davidstrasak/Bachelors_Text/images/MobilniSetup.png

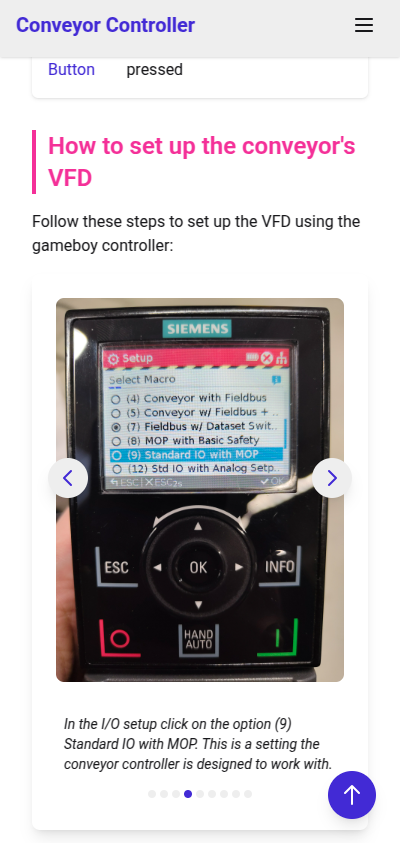
images/MobilniSetup.png
