davidstrasak/Bachelors_Text/images/zadni_LCD_s_I2C.jpg

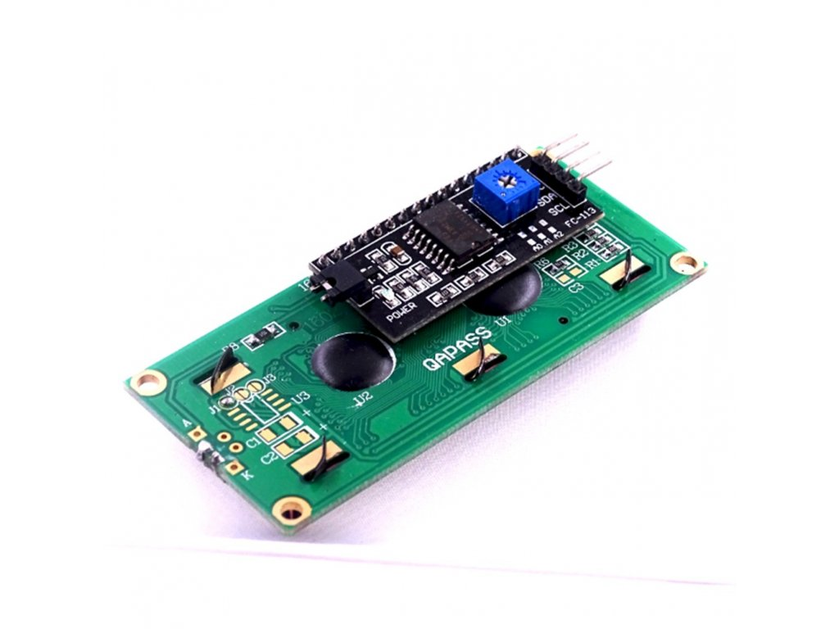
images/zadni_LCD_s_I2C.jpg
