davidstrasak/Bachelors_Text/chapters/seznamy.tex

\chapter*{Seznam zkratek a symbolů}
\addcontentsline{toc}{chapter}{Seznam zkratek a symbolů}
\label{chap:loa}
\begin{itemize}
    \item[\textbf{DPS}] Deska plošných spojů

    \item[\textbf{CSS}] Cascading Style Sheets

    \item[\textbf{HTML}] Hypertext Markup Language

    \item[\textbf{JS}] JavaScript

    \item[\textbf{PLC}] Programovatelný logický automat

    \item[\textbf{GPIO}] General Purpose Input Output

    \item[\textbf{SDK}] Software Development Kit

    \item[\textbf{IoT}] Internet of Things

    \item[\textbf{mDNS}] multicast Domain Name System

    \item[\textbf{SDA}] I2C - serial data line

    \item[\textbf{SCL}] I2C - serial clock line
\end{itemize}

\printbibliography[heading=bibintoc,title={Seznam zdrojů}]

\listoffigures

%\listoftables
%
\chapter*{Seznam příloh}
\addcontentsline{toc}{chapter}{Seznam příloh}

\section*{Přílohy uvnitř .zip souboru}
\begin{itemize}
	\item Instalační soubor mobilní aplikace ve formátu .apk
	\item 3D modely schránky pro desku plošných spojů ve formátu .stl
	\item Složka obsahující firmware pro vývojovou desku WEMOS D1 Mini Pro, která je kompatibilní s vývojovým prostředím PlatformIO
\end{itemize}

\section*{Přílohy dostupné online}
Z důvodu příliš velké velikosti těchto souborů jsou tyto přílohy hostované na serveru github.com, kde jsou veřejně dostupné.
\begin{itemize}
	\item KICAD projekt desky plošných spojů: \url{https://github.com/davidstrasak/Bachelors_PCB}
	\item Software webové verze mobilní aplikace před konverzí do .apk souboru: \url{https://github.com/davidstrasak/Bachelors_PhoneApp}
\end{itemize}
