davidstrasak/Bachelors_Text/codes/ConveyorControllerHeader.tex

\begin{lstlisting}[language=C++, caption={Header soubor ConveyorController Objektu}, label={lst:ConveyorControllerHeader}]
#ifndef CONVEYORCONTROLLER_H
#define CONVEYORCONTROLLER_H

#include <Arduino.h>
#include <ESP8266WebServer.h>
#include <ESP8266WiFi.h>
#include <ESP8266mDNS.h>
#include <LiquidCrystal_I2C.h>
#include <WiFiClient.h>
#include "pinDefinitions.h"
#include <Ticker.h>

class ConveyorController {
public:
  ConveyorController(const char* wifiNetworkName,
    const char* wifiNetworkPassword);

  void initIO();
  void initLCD();
  void initWeb();
  void assignRoutes();
  void startWebServer();
  void startTicker();
  void handleClient();
  void updateLCD();
  void updateState();

private:
  // WiFi credentials
  const char* wifiNetworkName;
  const char* wifiNetworkPassword;

  // Web server
  ESP8266WebServer webServer = ESP8266WebServer(80);

  // LCD
  LiquidCrystal_I2C lcd = LiquidCrystal_I2C(0x27, 16, 2);

  // Ticker
  Ticker inputCheckingTicker;
  Ticker LCDUpdatingTicker;

  // Speed of the conveyor
  int conveyorSpeed = 0;

  // TRUE or FALSE state if the conveyor is controlled locally or remotely
  // remoteLocalState ? "local" : "remote"
  bool remoteLocalState = false;

  // TRUE or FALSE state if the conveyor is speeding up or no
  bool locIncSpeedState = false;
  bool remIncSpeedState = false;

  // TRUE or FALSE state if the conveyor is slowing down or no
  bool locDecSpeedState = false;
  bool remDecSpeedState = false;

  // TRUE or FALSE state if the conveyor is ON or OFF
  bool locOnOffState = false;
  bool remOnOffState = false;

  // Route handler for the main page
  void mainRoute();

  // Route handler for unknown pages
  void unknownRouteResponse();

  void LCDWaitingForConnection(bool condition);

  void writeValue(int pin, int value);
};

#endif
\end{lstlisting}
