davidstrasak/Bachelors_Text/images/StateFlow_Firmwaru_left.drawio.pdf

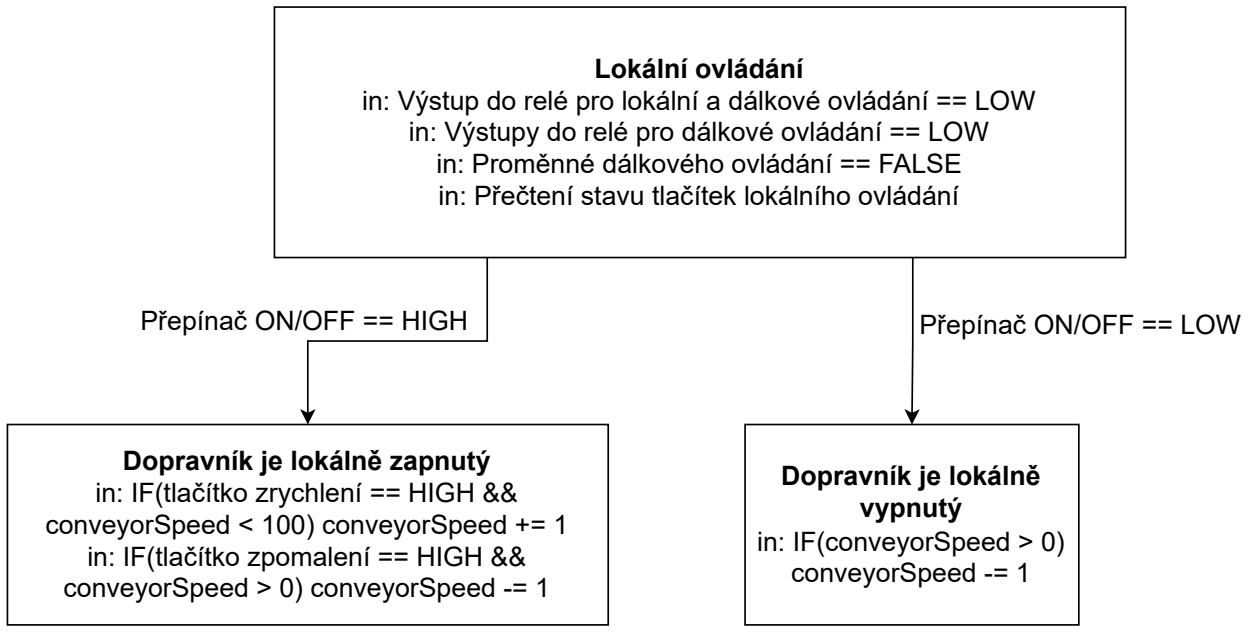
[picture p3: figure]
Lokální ovládání; Dopravník je lokálně zapnutý in: IF(tlačítko zrychlení == HIGH && conveyorSpeed < 100) conveyorSpeed += 1 in: IF(tlačítko zpomalení == HIGH && conveyorSpeed > 0) conveyorSpeed -= 1; Dopravník je lokálně vypnutý in: IF(conveyorSpeed > 0) conveyorSpeed -= 1

Přepínač ON/OFF == HIGH | Přepínač ON/OFF == LOW

in: Výstup do relé pro lokální a dálkové ovládání == LOW in: Výstupy do relé pro dálkové ovládání == LOW in: Proměnné dálkového ovládání == FALSE
in: Přečtení stavu tlačítek lokálního ovládání
