davidstrasak/Bachelors_Text/images/StateFlow_Firmwaru_right.drawio.pdf

Proměnná ON/OFF == FALSE | Proměnná ON/OFF == TRUE

Dálkové ovládání
in: Výstup do relé pro lokální a dálkové ovládání == HIGH (proměnné pro dálkové ovládání se nastavují přes webové GET požadavky mimo tuto funkci)

Dopravník je dálkově
vypnutý
in: Výstupy do relé pro
dálkové ovládání == LOW
in: IF(conveyorSpeed > 0)
conveyorSpeed -= 1

Dopravník je dálkově zapnutý
in: Výstupy do relé pro dálkové ovládání se nastaví podle proměnných
in: IF(proměnná dálkové zrychlení == TRUE && proměnná dálkové zpomalení == TRUE)
Oba výstupy dálkového zpomalení i zrychlení == LOW in: IF(proměnná zrychlení == HIGH && conveyorSpeed <
100) conveyorSpeed += 1
in: IF(proměnná zpomalení == HIGH && conveyorSpeed > 0) conveyorSpeed -= 1
