davidstrasak/Bachelors_Text/2025_BP_Strasak_David_219502/README.txt

V příloze není možné mít všechny zpracované soubory kvůli 15MB limitu daným školou na velikost příloh závěrečných prací.

V příloze tedy je možné najít:
- Instalační soubor mobilní aplikace ve formátu .apk
- 3D modely schránky pro desku plošných spojů ve formátu .stl
- Složku obsahující firmware pro vývojovou desku WEMOS D1 Mini Pro, která je kompatibilní s vývojovým prostředím PlatformIO

Zbylé části systému nebylo možné kvůli velikosti přidat do přílohy práce. Jsou ale veřejně dostupné na serveru github.com, kde si je může kdokoliv stáhnout ve formátu .zip. 

Odkazy na zbylé hostované části aplikace:
- KICAD projekt desky plošných spojů: https://github.com/davidstrasak/Bachelors_PCB
- Software webové verze mobilní aplikace před konverzí do .apk souboru: https://github.com/davidstrasak/Bachelors_PhoneApp
