davidstrasak/Bachelors_Text/images/LandingPage_Annot.drawio.pdf

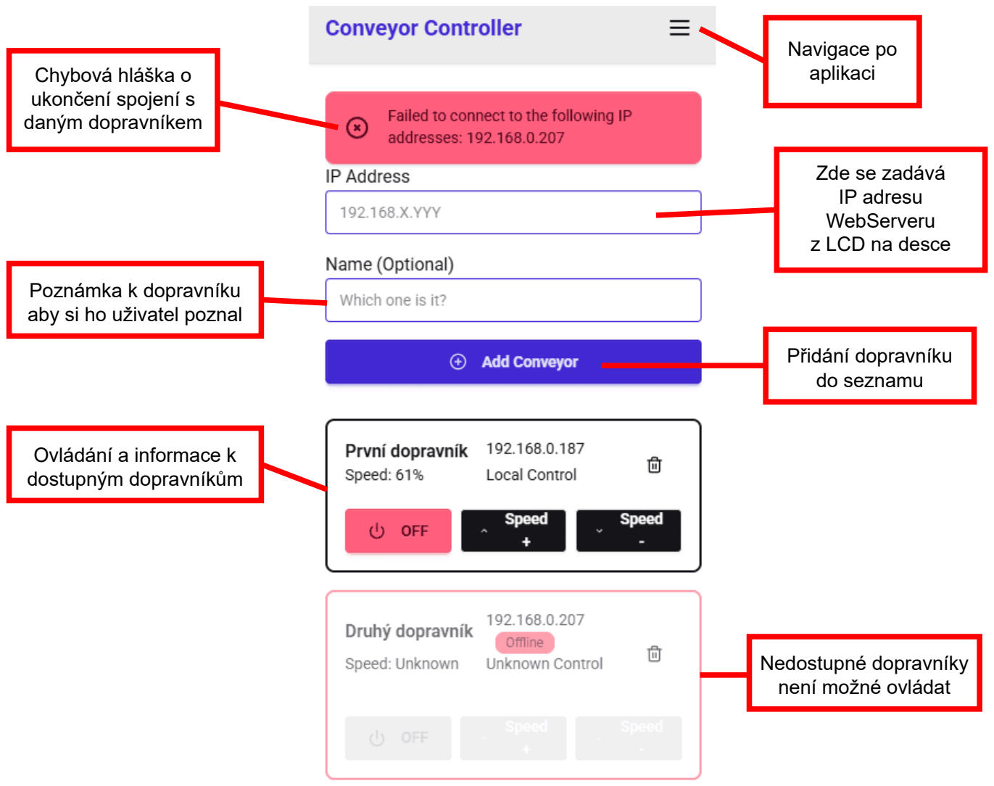
[picture p4: page 1]

Navigace po
aplikaci

Zde se zadává
IP adresu
WebServeru
z LCD na desce

Přidání dopravníku
do seznamu

Nedostupné dopravníky
není možné ovládat

Ovládání a informace k
dostupným dopravníkům

Poznámka k dopravníku
aby si ho uživatel poznal

Chybová hláška o
ukončení spojení s
daným dopravníkem
