davidstrasak/Bachelors_Text/images/StateFlow_Firmwaru_top.drawio.pdf

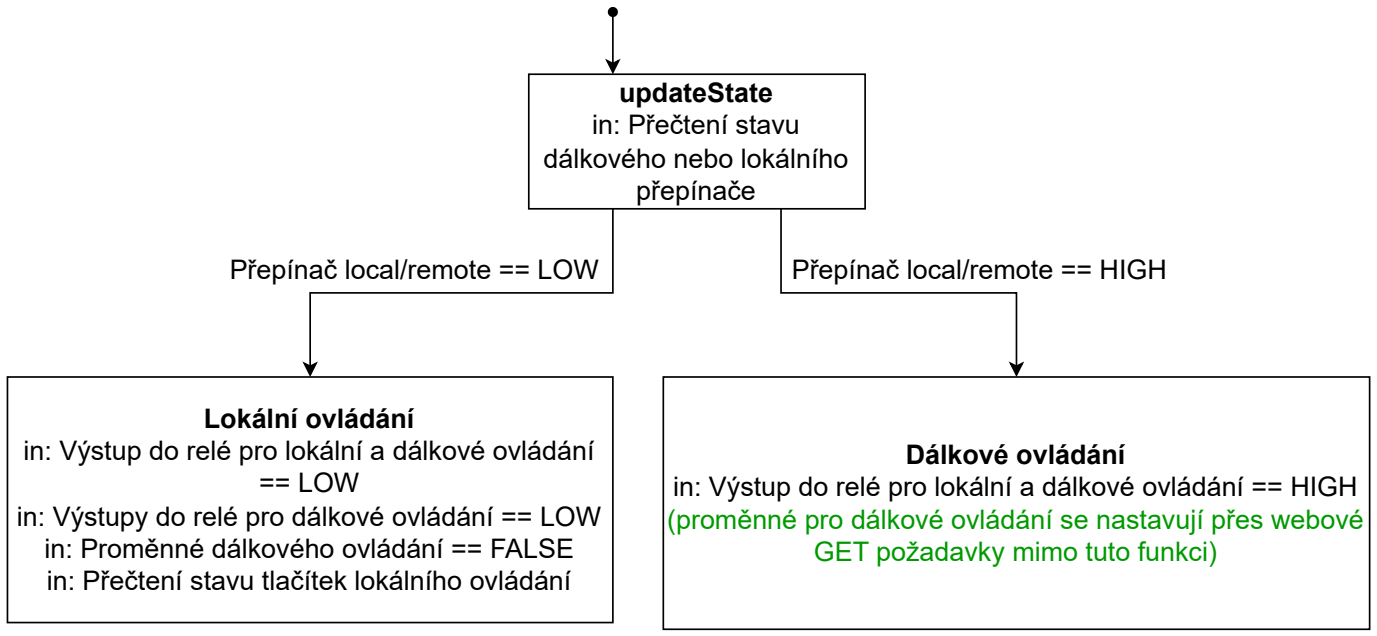
[picture p5: figure]
Přepínač local/remote == LOW; Přepínač local/remote == HIGH; updateState in: Přečtení stavu dálkového nebo lokálního přepínače; Lokální ovládání; == LOW; Dálkové ovládání; GET požadavky mimo tuto funkci)

in: Výstup do relé pro lokální a dálkové ovládání

in: Výstupy do relé pro dálkové ovládání == LOW in: Proměnné dálkového ovládání == FALSE in: Přečtení stavu tlačítek lokálního ovládání in: Výstup do relé pro lokální a dálkové ovládání == HIGH (proměnné pro dálkové ovládání se nastavují přes webové
