davidstrasak/Bachelors_Text/images/BrnenskaHoneywellHala.png

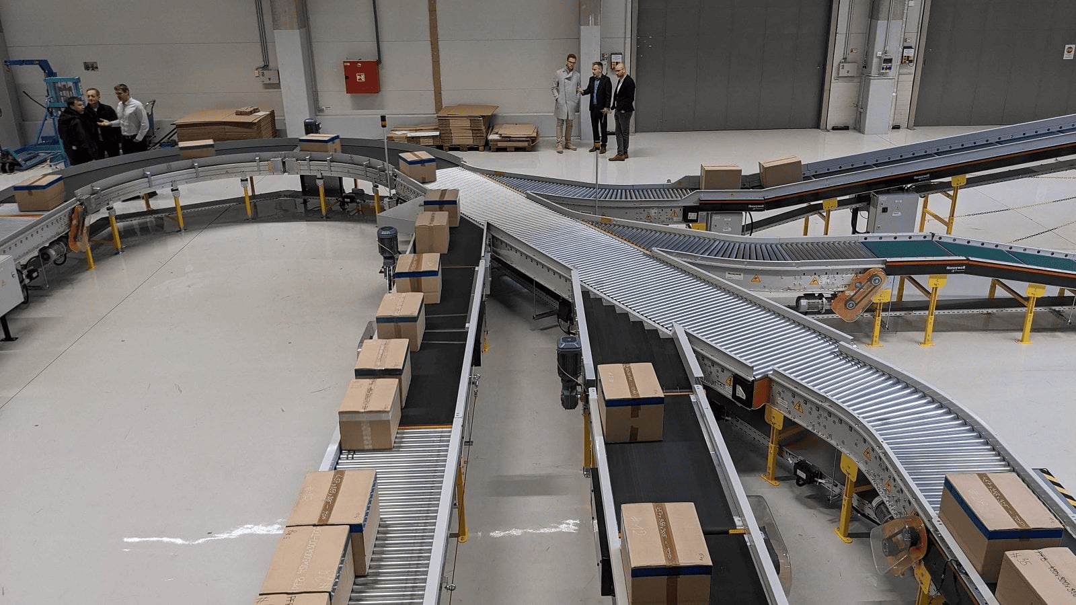
images/BrnenskaHoneywellHala.png
