davidstrasak/Bachelors_Text/images/CU240comissioning.png

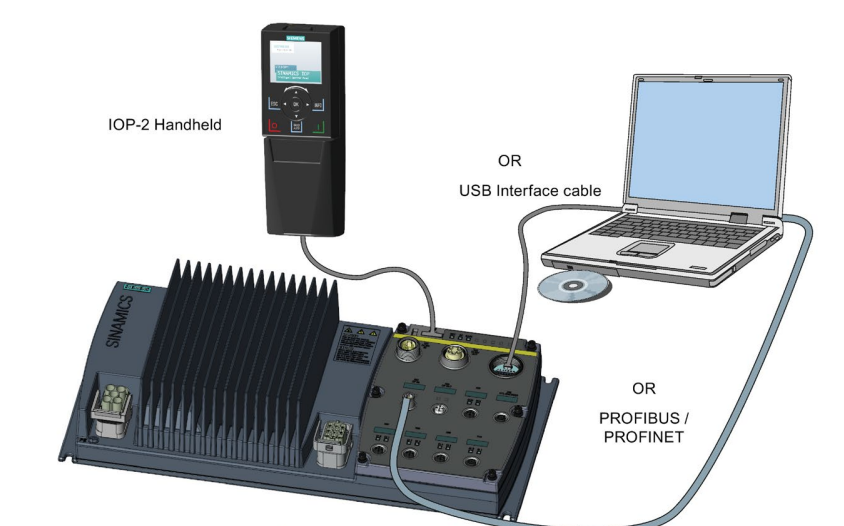
images/CU240comissioning.png
