davidstrasak/Bachelors_Text/images/ESPWebserverUkazka.png

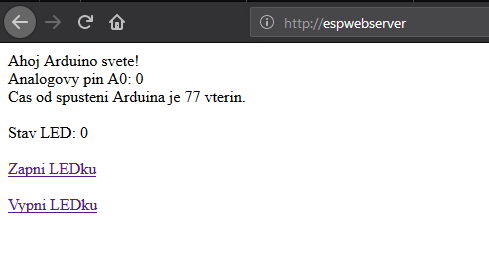
images/ESPWebserverUkazka.png
