davidstrasak/Bachelors_Text/images/FunkcniSchema_DvaOvladace.png

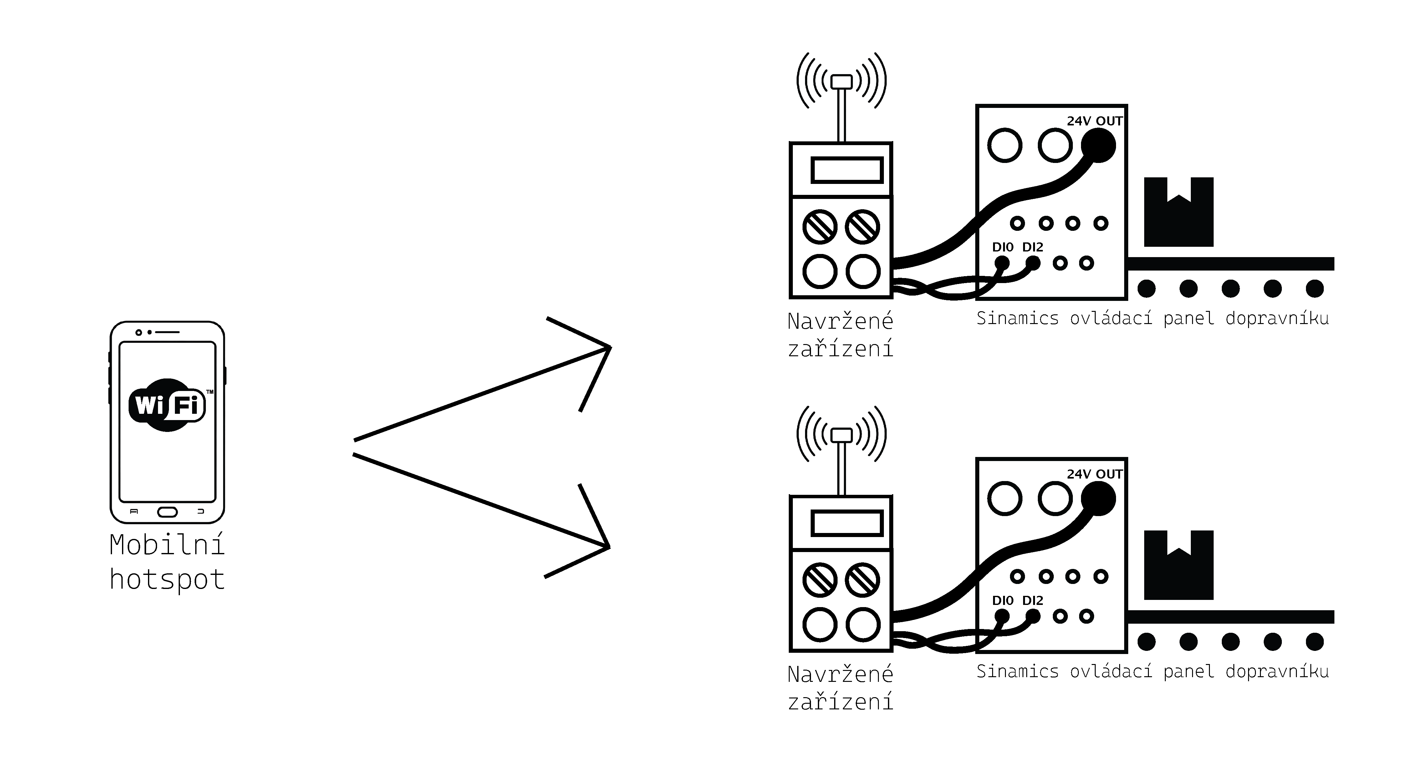
images/FunkcniSchema_DvaOvladace.png
