davidstrasak/Bachelors_Text/images/krabickaTop.png

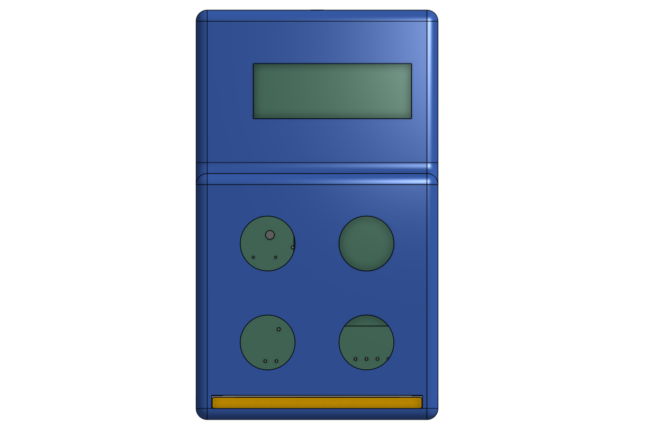
images/krabickaTop.png
