davidstrasak/Bachelors_Text/images/KrabickaZBoku.png

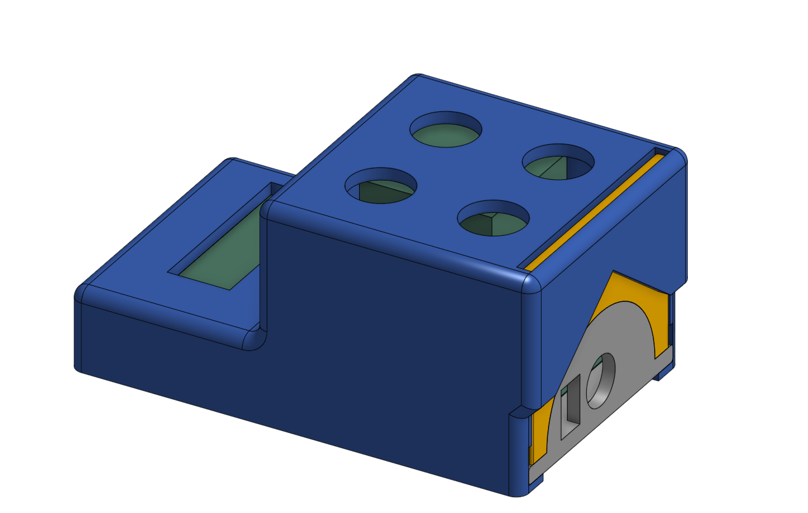
images/KrabickaZBoku.png
