davidstrasak/Bachelors_Text/images/MobilniHelp.png

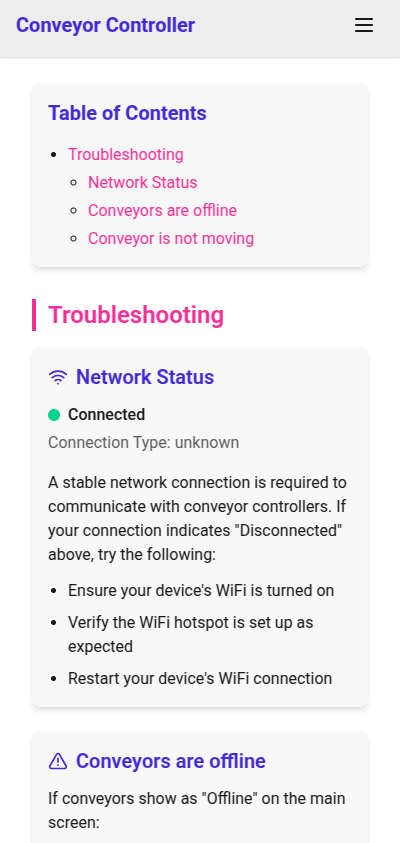
images/MobilniHelp.png
