davidstrasak/Bachelors_Text/images/MobilniLanding.png

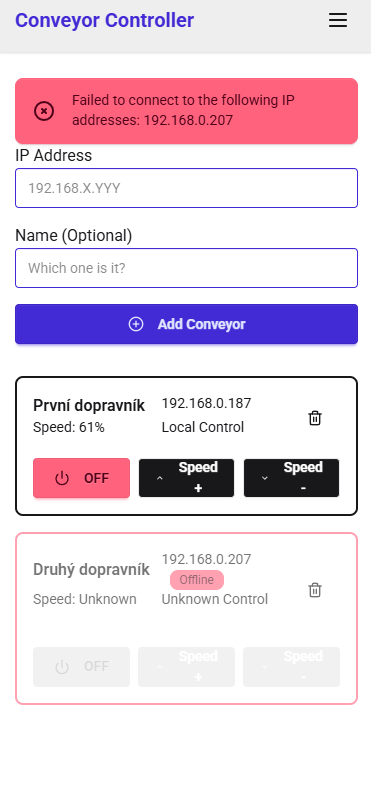
images/MobilniLanding.png
