davidstrasak/Bachelors_Text/images/PCB_Final.jpg

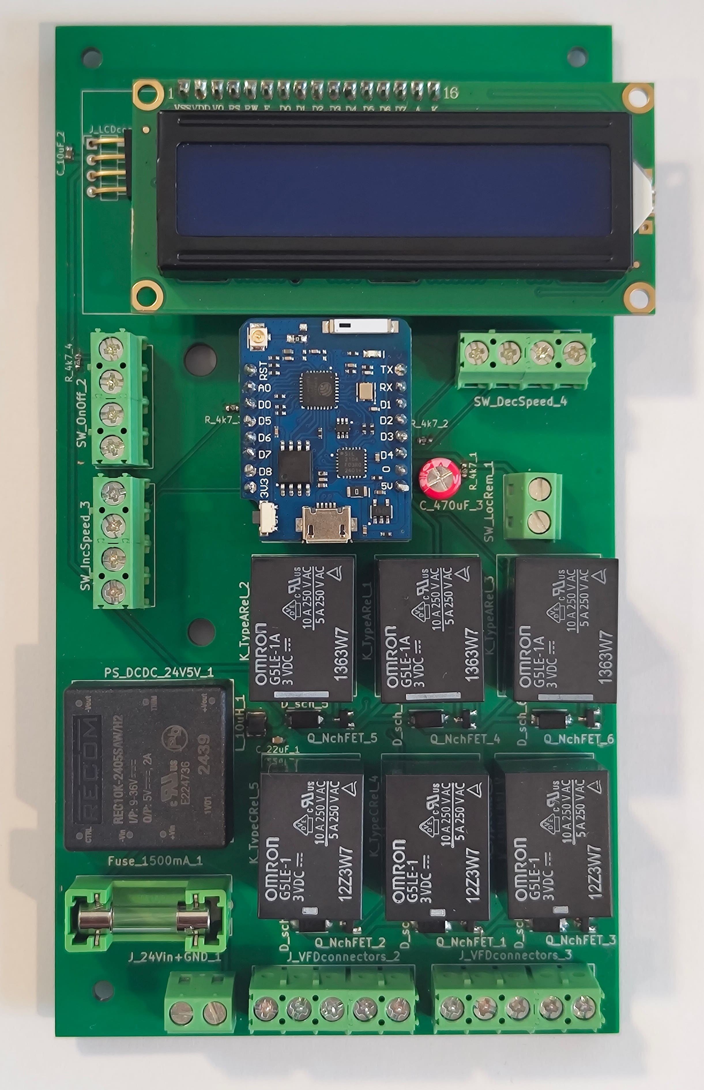
images/PCB_Final.jpg
