davidstrasak/Bachelors_Text/images/PCB_Final_annotated.jpg

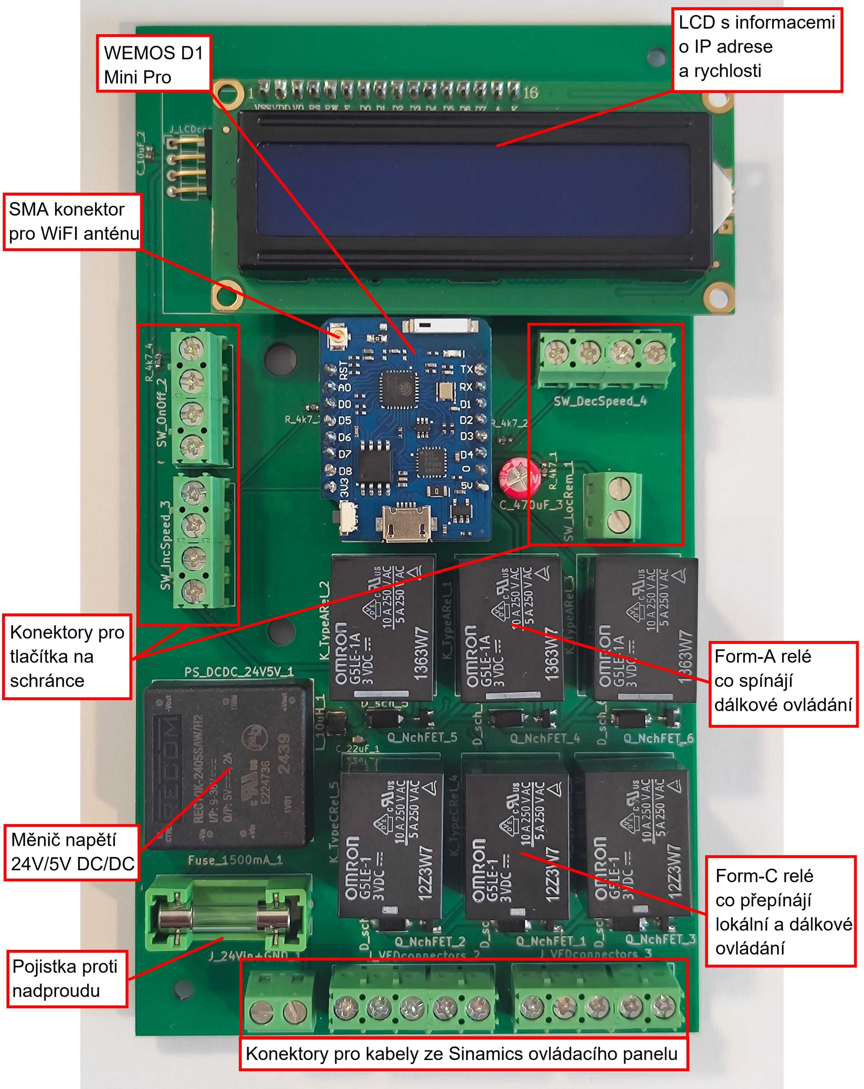
images/PCB_Final_annotated.jpg
