davidstrasak/Bachelors_Text/images/PCBback.png

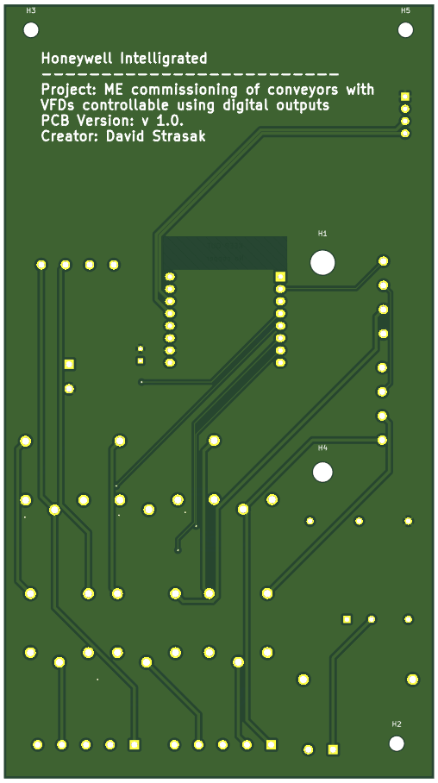
images/PCBback.png
