davidstrasak/Bachelors_Text/images/PCBfront.png

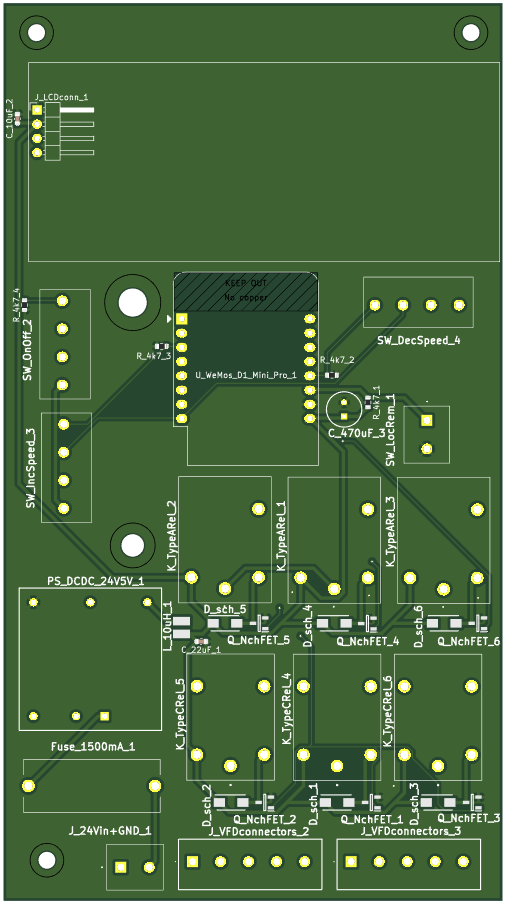
images/PCBfront.png
