davidstrasak/Bachelors_Text/images/Platformio_Ukazka.png

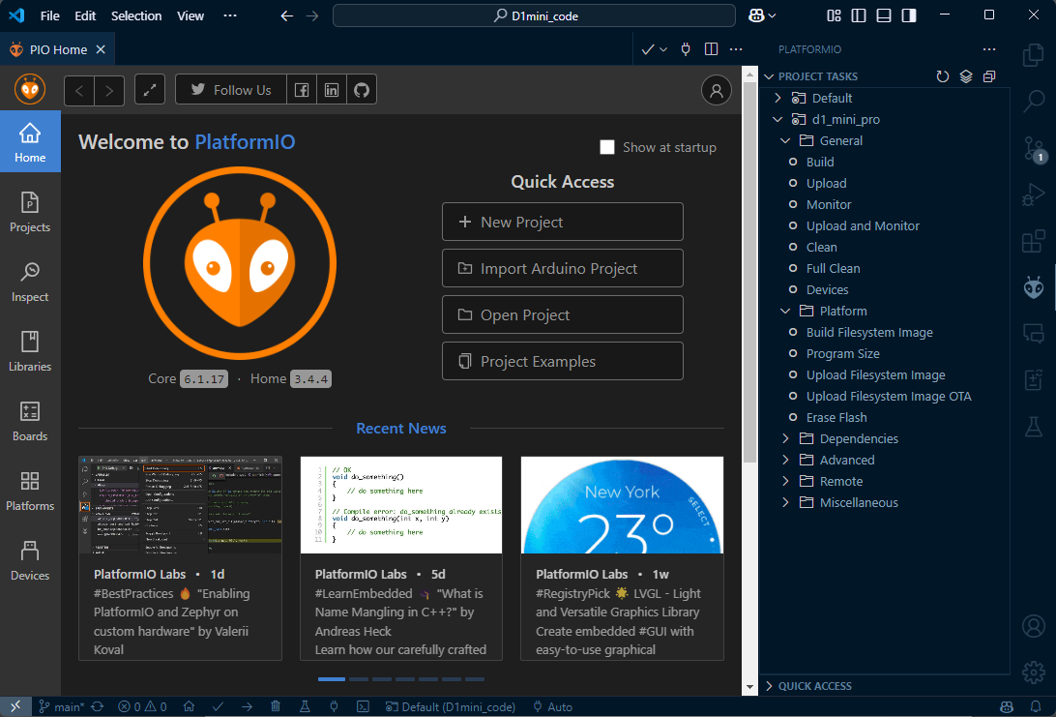
images/Platformio_Ukazka.png
