davidstrasak/Bachelors_Text/images/predni_LCD_s_I2C.jpg

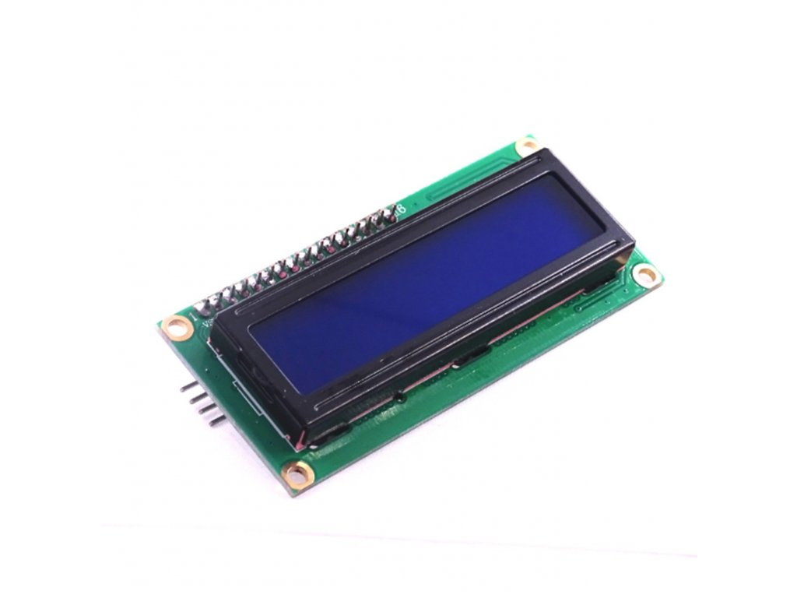
images/predni_LCD_s_I2C.jpg
