davidstrasak/Bachelors_Text/images/ProvozniRezimyAMSFrekvencnimMenicem.png

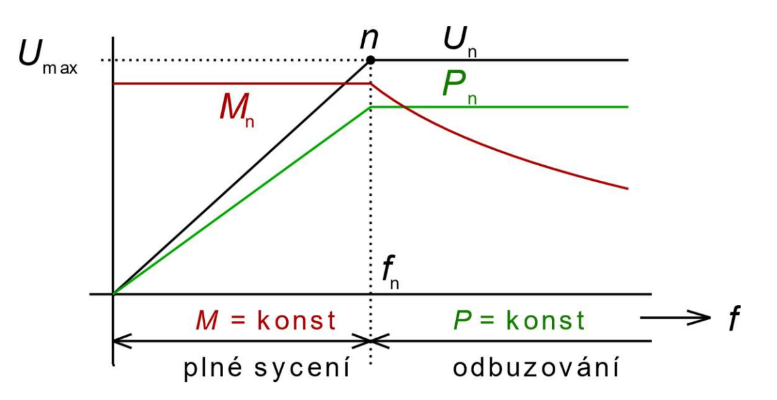
images/ProvozniRezimyAMSFrekvencnimMenicem.png
