davidstrasak/Bachelors_Text/images/Sinamics_G120D.png

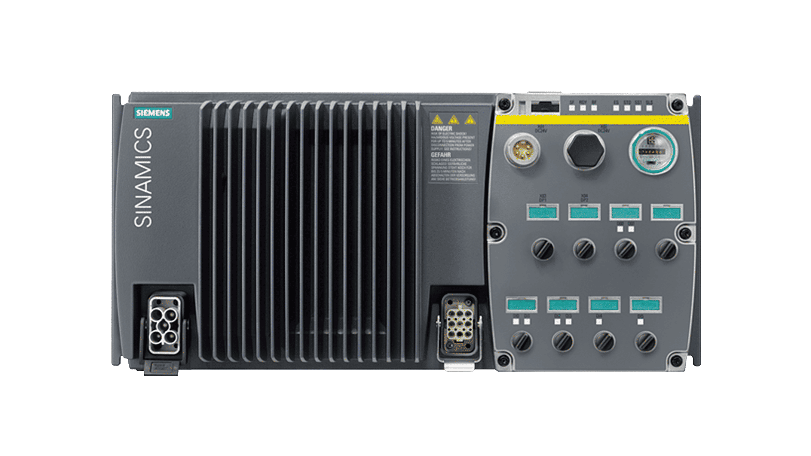
images/Sinamics_G120D.png
