davidstrasak/Bachelors_Text/images/stateFlow kódu.jpg

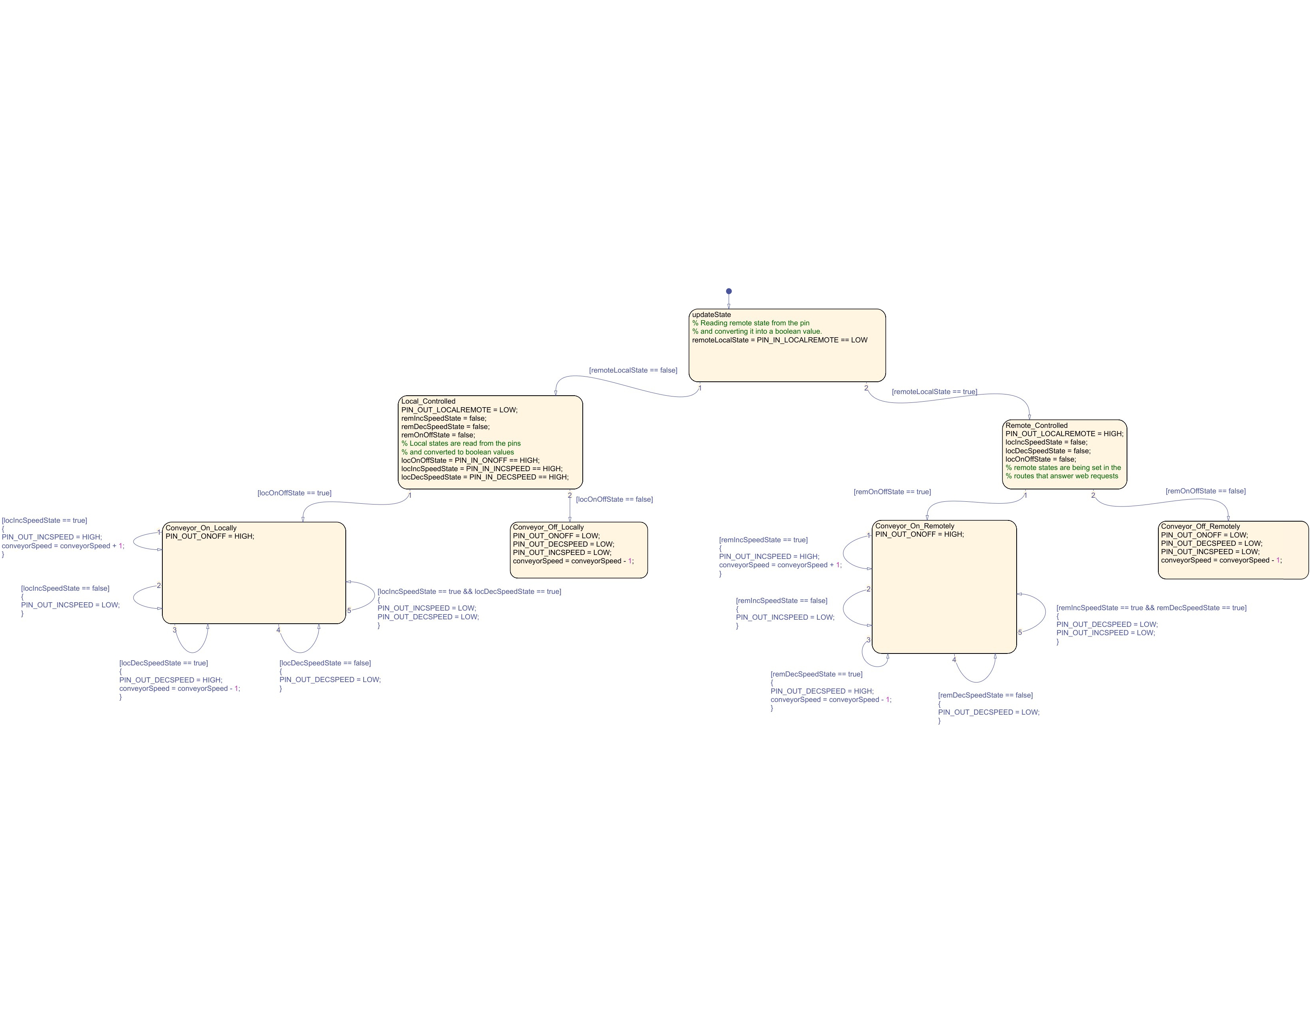
images/stateFlow kódu.jpg
