davidstrasak/Bachelors_Text/images/WebServerLandingPage.png

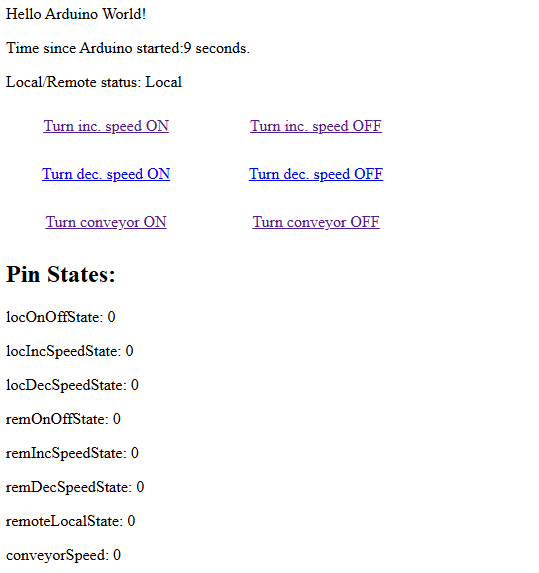
images/WebServerLandingPage.png
