davidstrasak/Bachelors_Text/images/WEMOS_D1_Mini_Pro.png

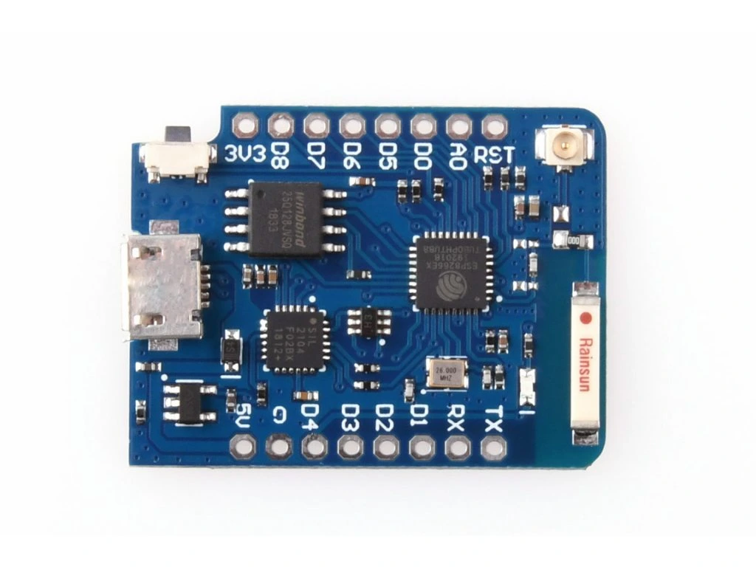
images/WEMOS_D1_Mini_Pro.png
