davidstrasak/Bachelors_Text/2025_BP_Strasak_David_219502/3D Model schránky/PCB parts - Bottom.stl

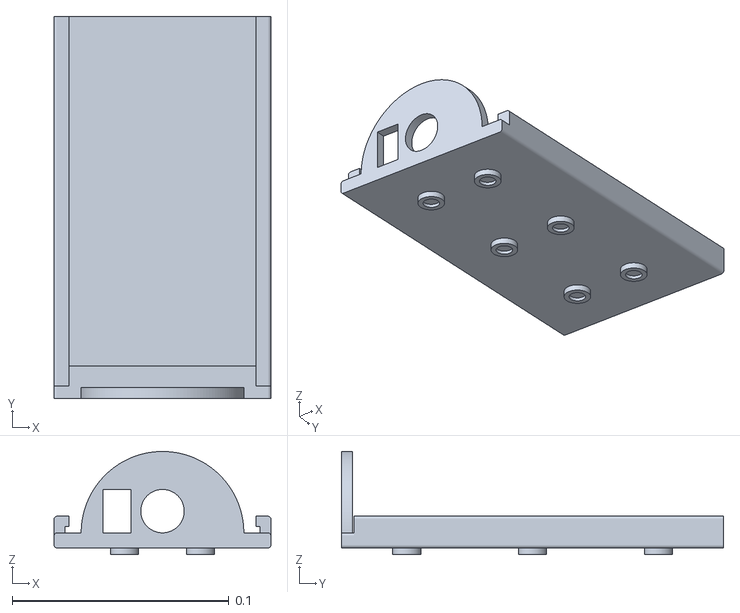
[picture p25: CAD file, 2025-05-21]
2025_BP_Strasak_David_219502/3D Model schránky/PCB parts - Bottom.stl
0.1 x 0.176 x 0.0475
