davidstrasak/Bachelors_Text/2025_BP_Strasak_David_219502/3D Model schránky/PCB parts - Top.stl

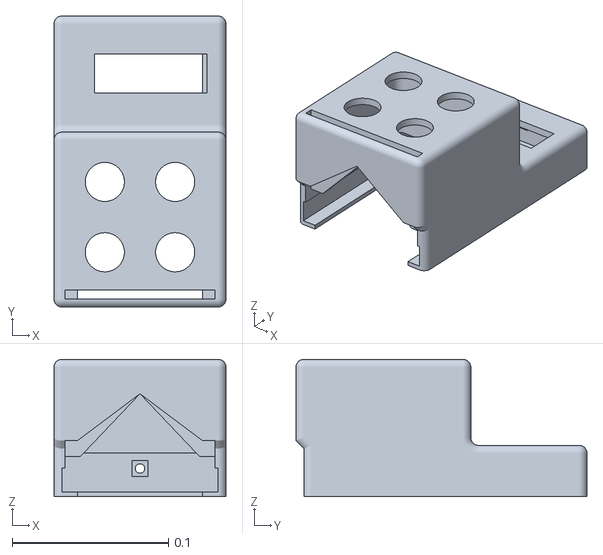
[picture p26: CAD file, 2025-05-21]
2025_BP_Strasak_David_219502/3D Model schránky/PCB parts - Top.stl
0.11 x 0.186 x 0.0878
