davidstrasak/Bachelors_Text/2025_BP_Strasak_David_219502/3D Model schránky/PCB parts - Gate.stl

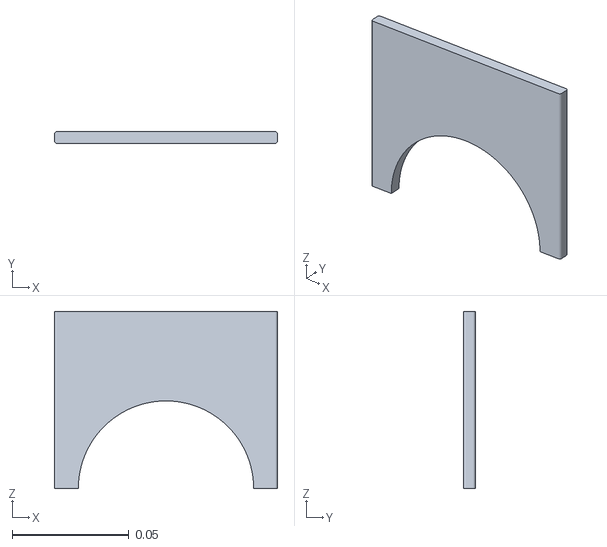
[picture p27: CAD file, 2025-05-21]
2025_BP_Strasak_David_219502/3D Model schránky/PCB parts - Gate.stl
0.0954 x 0.005 x 0.0758
