davidstrasak/Bachelors_Text/images/OvladaniRele.drawio.pdf

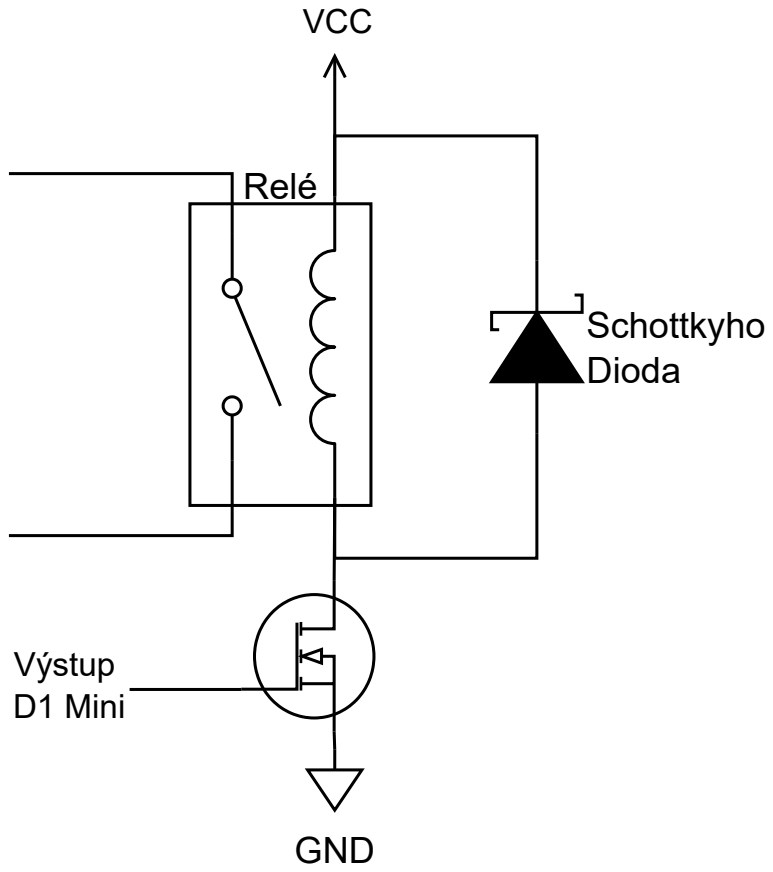
[picture p28: page 1]
VCC; Výstup D1 Mini; GND; Schottkyho Dioda; Relé
