davidstrasak/Bachelors_Text/images/SchemaDesky.pdf

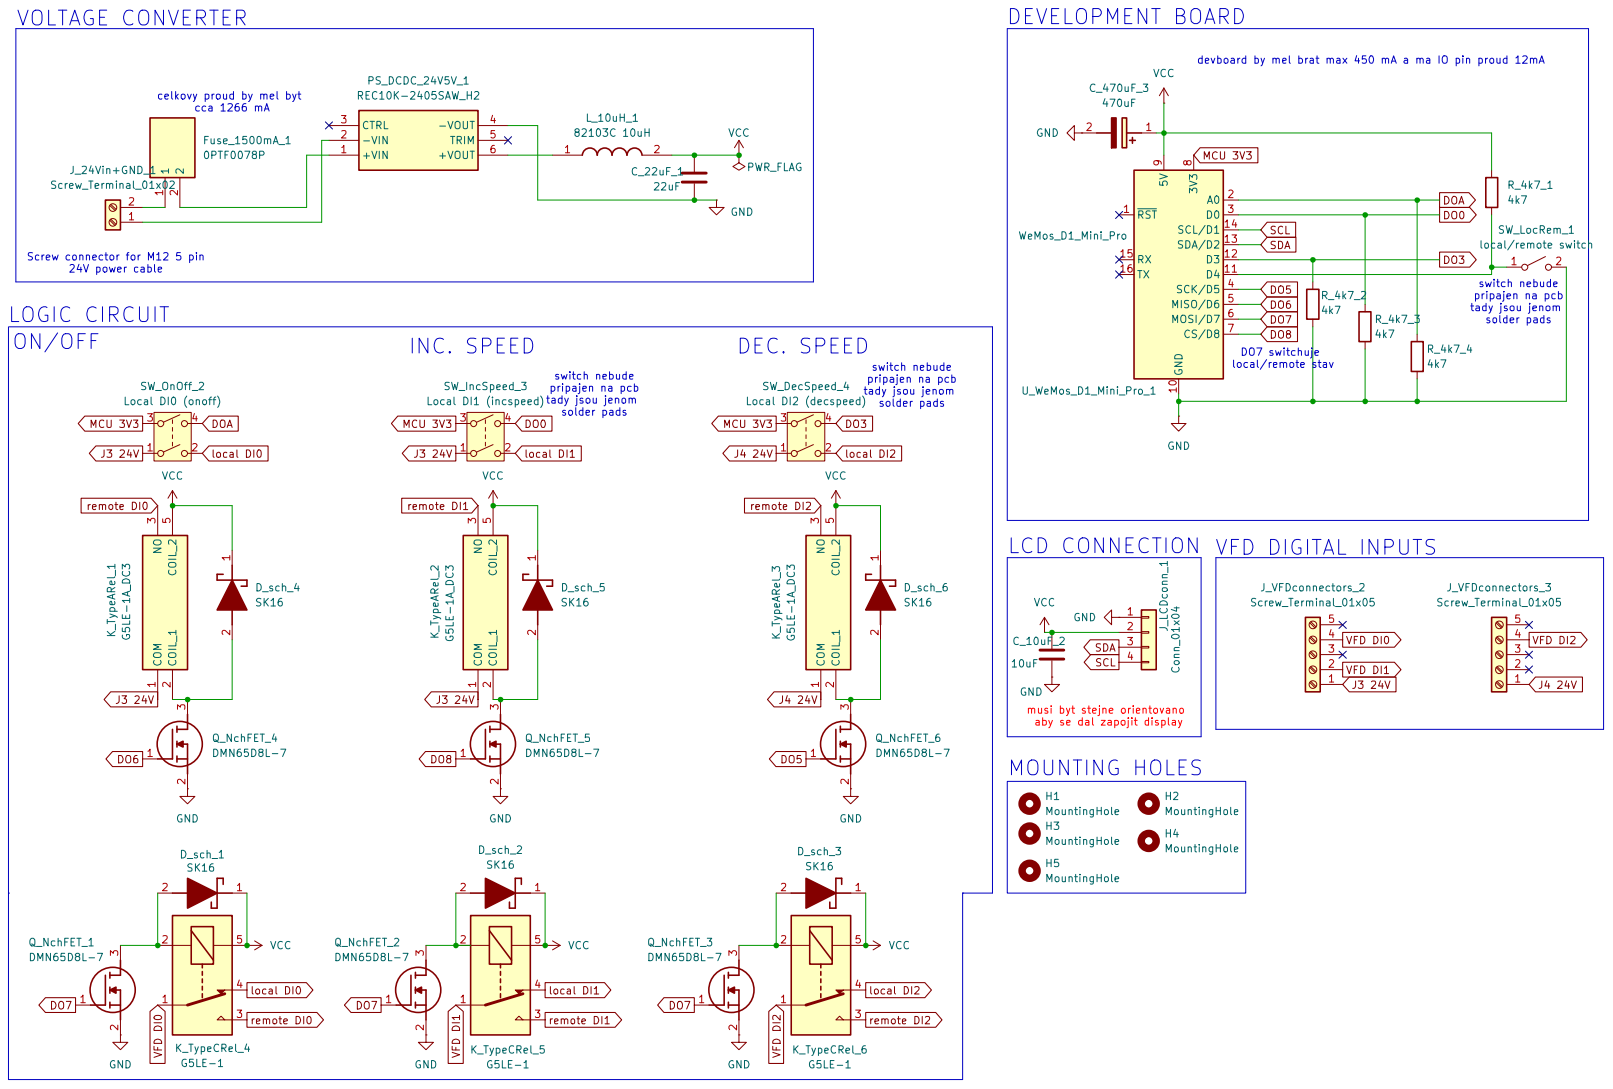
[picture p29: page 1]
