davidstrasak/Bachelors_Text/(commit log)

2025-05-04 conveyorController třída a objekt done
2025-05-22 Finish it all and upload to the school
    [PCB parts - Bottom.stl, PCB parts - Gate.stl, PCB parts - Top.stl]
